agben/Silicon-Heaven/Acorn-Electron/Cumana-Disk-Interface/Cumana-Disk-Interface-pcb-top.png

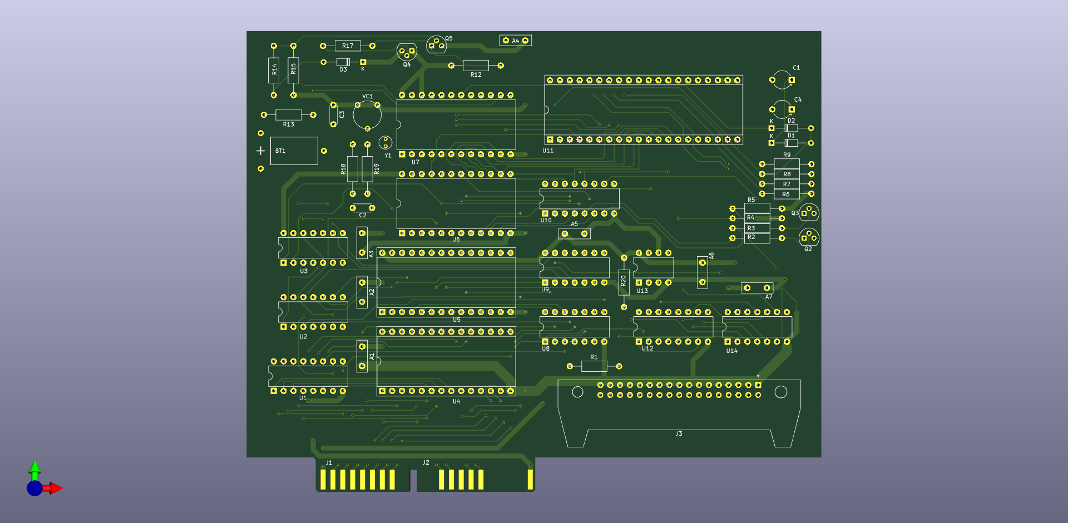
Acorn-Electron/Cumana-Disk-Interface/Cumana-Disk-Interface-pcb-top.png
