agben/Silicon-Heaven/Acorn-Electron/Cumana-Disk-Interface/Cumana-Disk-Interface-pcb-bottom.png

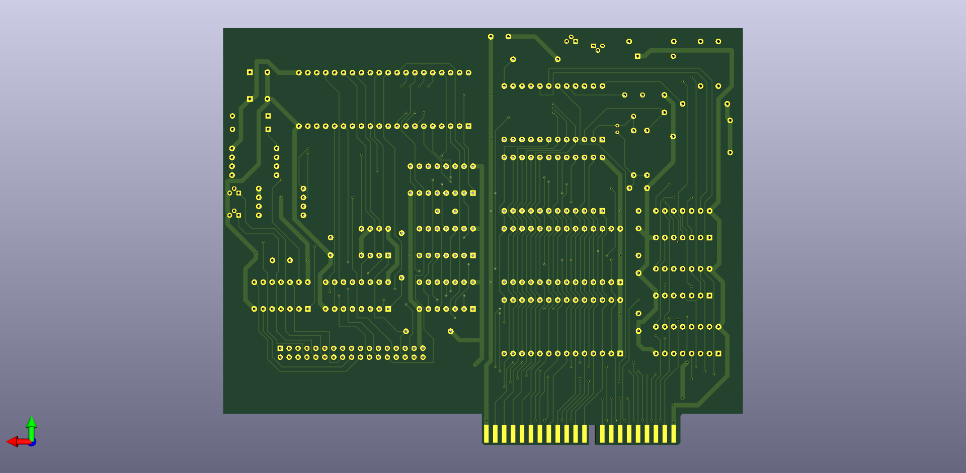
Acorn-Electron/Cumana-Disk-Interface/Cumana-Disk-Interface-pcb-bottom.png
