agben/Silicon-Heaven/README.md

**Silicon Heaven**
---
The afterlife for obsolete equipment and software.

For more on each entry see www.benningtons.net/index.php/category/silicon-heaven
