agben/Silicon-Heaven/Apple-II/Print-Buffer/schematic.pdf

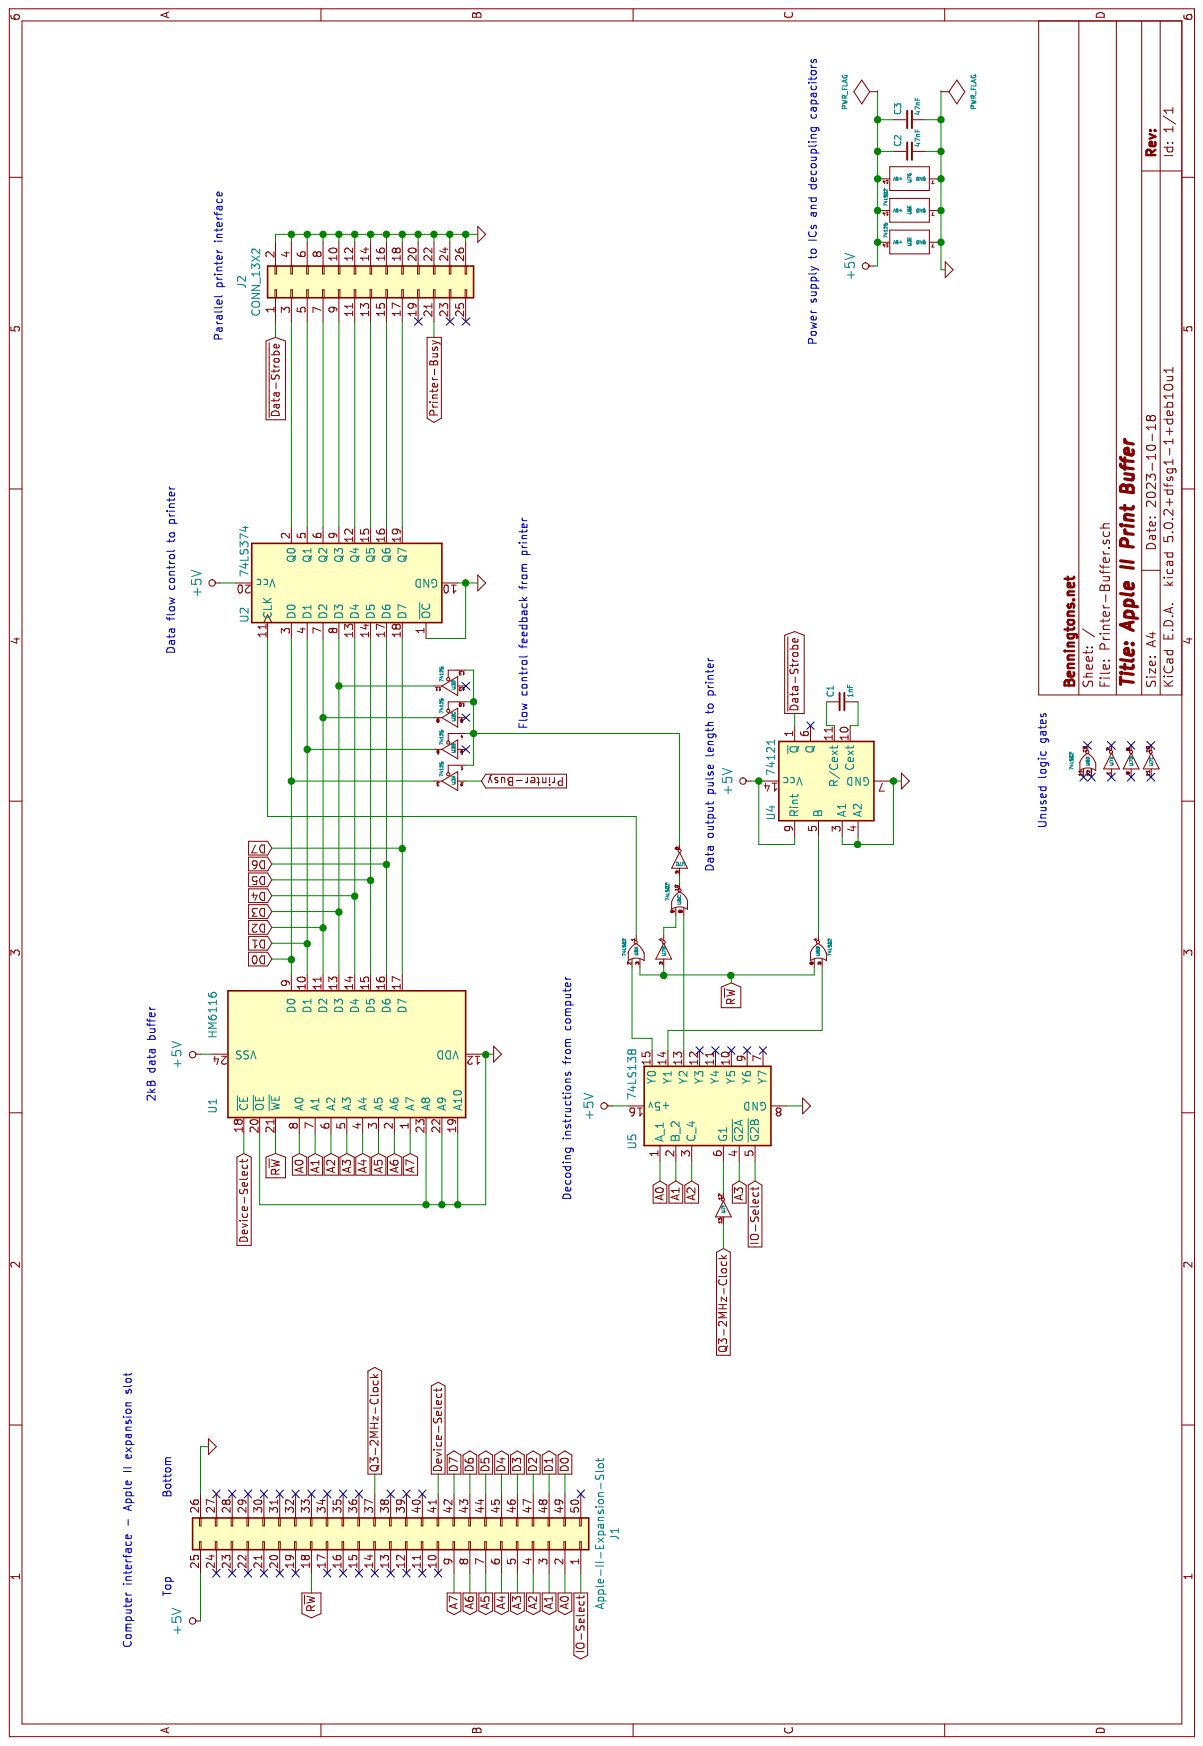
[picture p3: page 1]
