agben/Silicon-Heaven/Acorn-Electron/Cumana-Disk-Interface/schematic.pdf

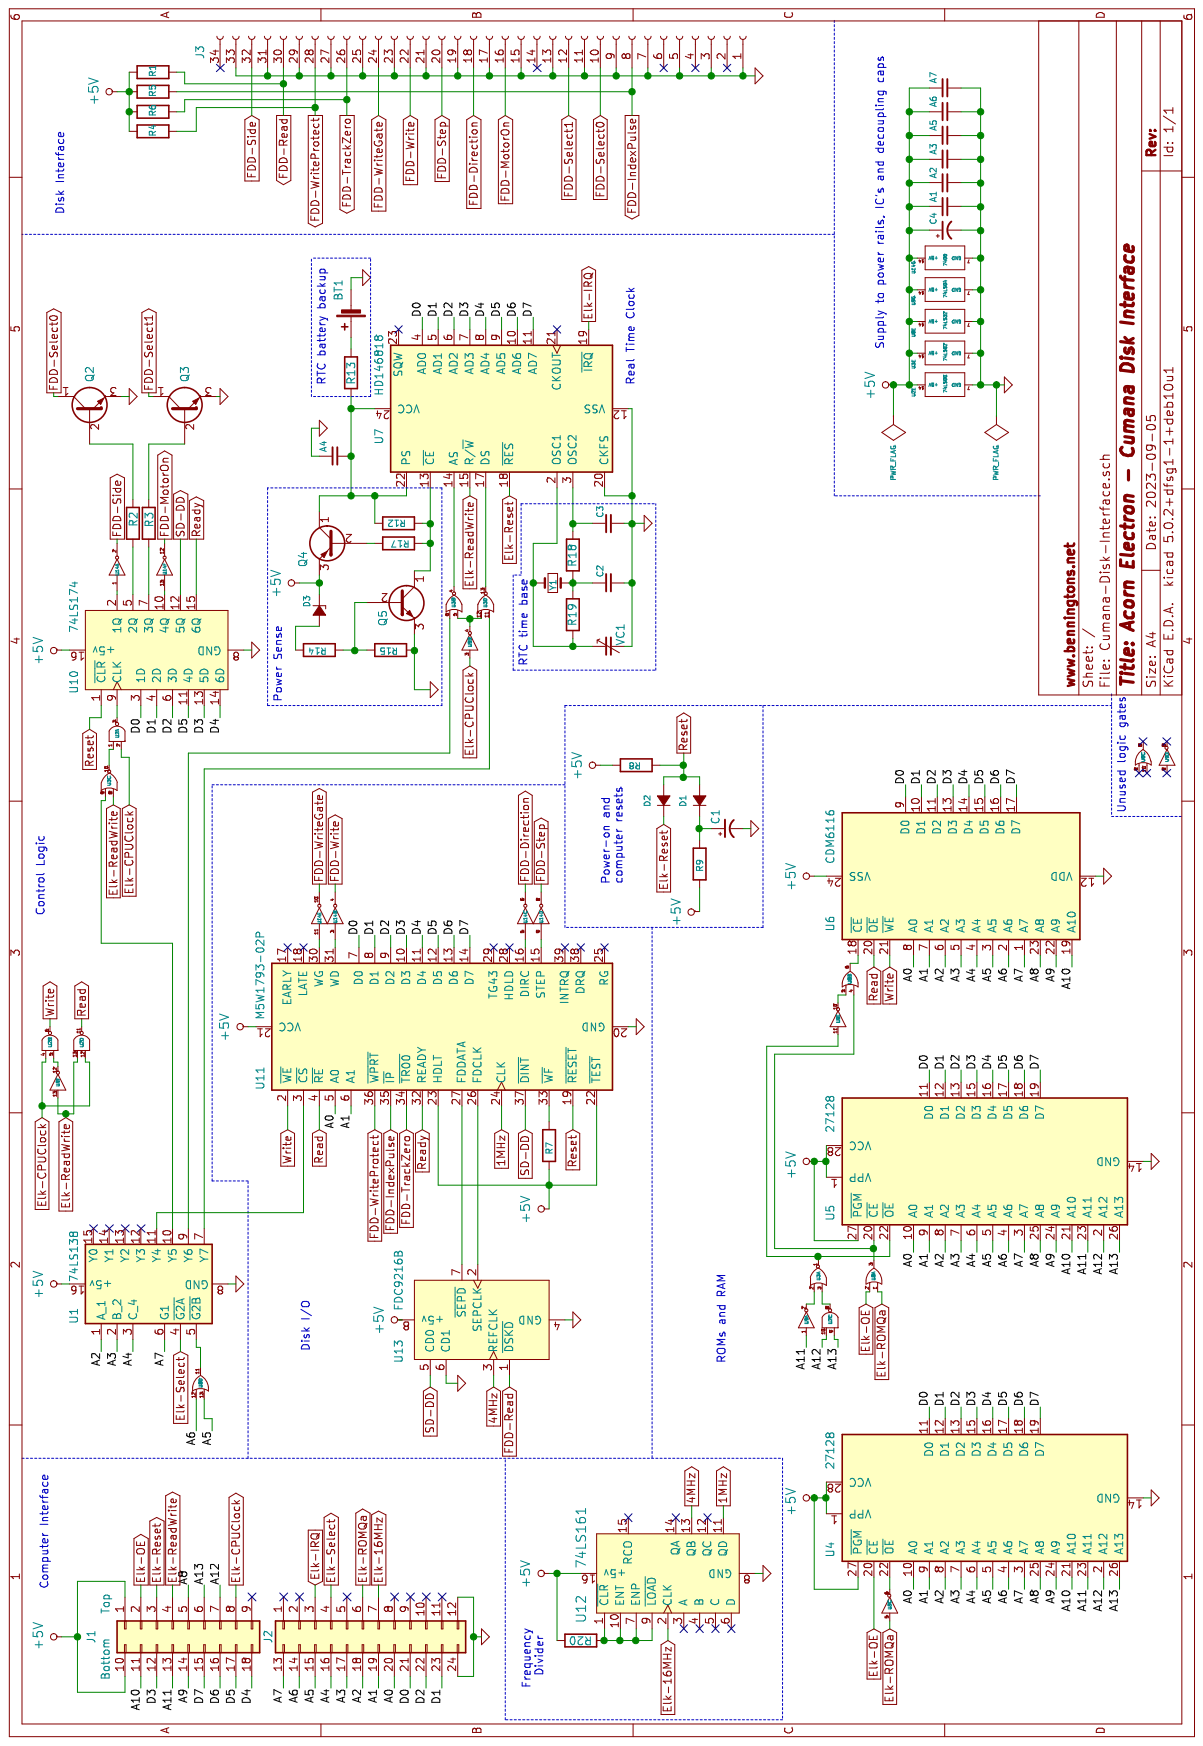
[picture p4: page 1]
