agben/Silicon-Heaven/Acorn-Electron/Cumana-Disk-Interface/Cumana-Disk-Interface.kicad_pcb

## KiCad design Acorn-Electron/Cumana-Disk-Interface/Cumana-Disk-Interface.kicad_pcb (2025-09-29)

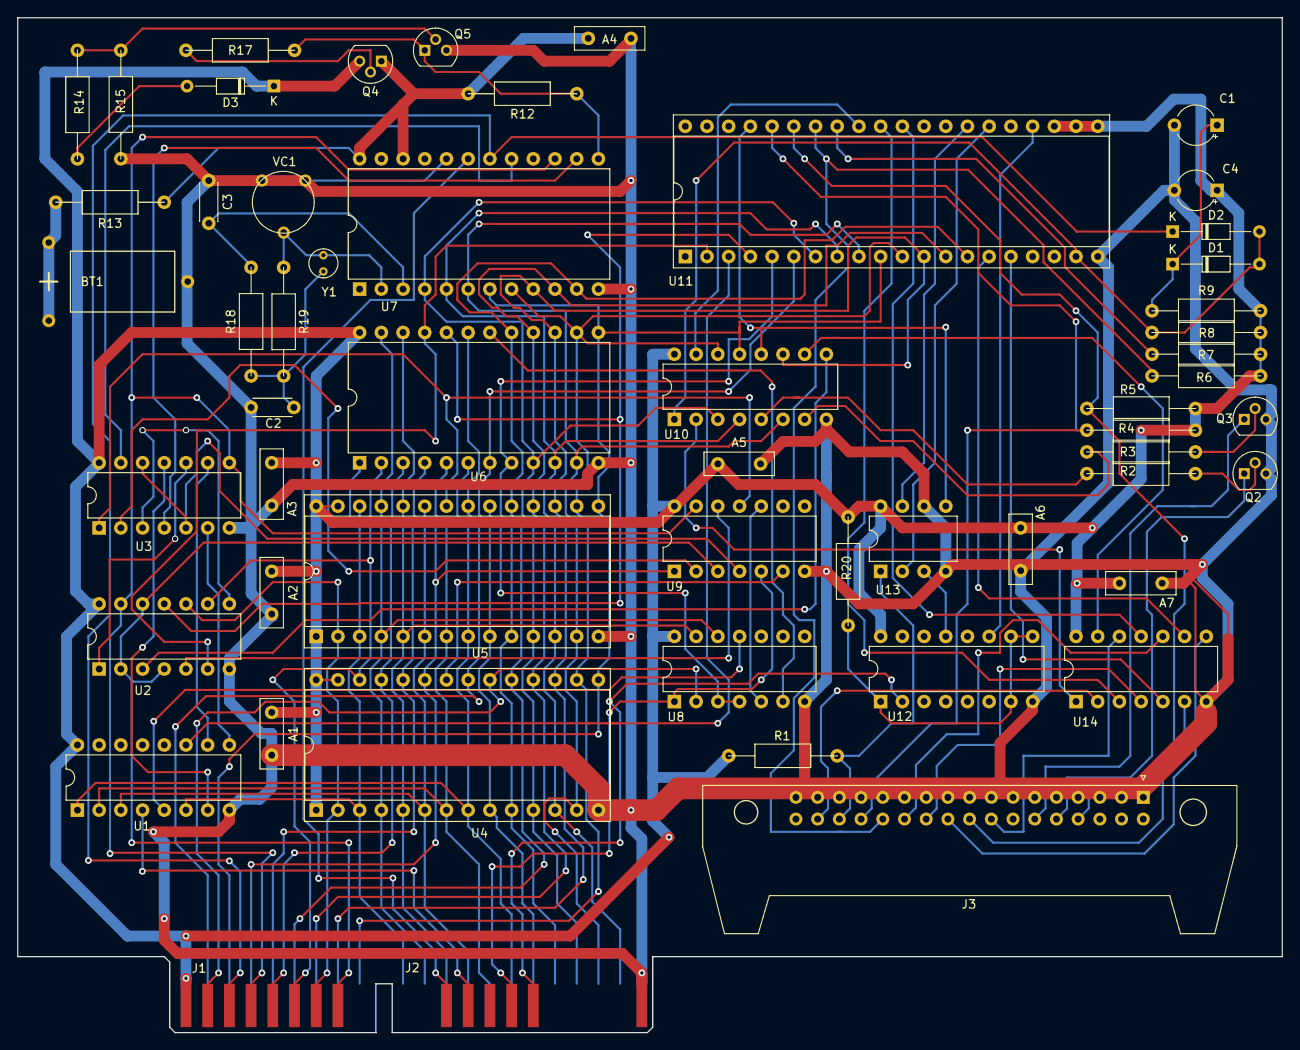
[picture p5: board Cumana-Disk-Interface.kicad_pcb from above]

Board: 2 copper layers, 148.0 x 118.7 mm, 55 parts (0 on the bottom side), 93 nets.

Parts:
A1, A2, A3, A4, A5, A6, A7: C; C_Disc_D8.0mm_W2.5mm_P5.00mm
BT1: Battery_Cell
C1, C4: CP1; CP_Radial_Tantal_D4.5mm_P5.00mm
C2, C3: C; C_Disc_D4.3mm_W1.9mm_P5.00mm
D1, D2: Diode; D_DO-34_SOD68_P10.16mm_Horizontal
D3: D_Zener; D_DO-34_SOD68_P10.16mm_Horizontal
J1: Bottom Top; Connector_2x9_P1.27mm_Polarized_Edge
J2: CONN_12X2; Connector_2x12_P1.27mm_Polarized_Edge
J3: Conn_01x34_Female; IDC-Header_2x17_P2.54mm_Horizontal_Lock
Q2, Q3, Q5: Q_NPN_CBE; TO-92
Q4: Q_PNP_CBE; TO-92
R1, R2, R3, R4, R5, R6, R7, R8, R9, R12, R13, R14, R15, R17, R18, R19, R20: R; R_Axial_DIN0212_L12.5mm_D2.5mm_Horizontal
U1: 74LS138; DIP-16_W7.62mm
U2: 74LS00; DIP-14_W7.62mm
U3: 74LS02; DIP-14_W7.62mm
U4, U5: 27128; DIP-28_W15.24mm_Socket
U6: CDM6116; DIP-24_W15.24mm
U7: HD146818; DIP-24_W15.24mm
U8: 74LS32; DIP-14_W7.62mm
U9: 74LS04; DIP-14_W7.62mm
U10: 74LS174; DIP-16_W7.62mm
U11: M5W1793-02P; DIP-40_W15.24mm_Socket
U12: 74LS161; DIP-16_W7.62mm
U13: FDC9216B; DIP-8_W7.62mm
U14: 7406; DIP-14_W7.62mm
VC1: C_Trimmer
Y1: Crystal_Small; Crystal_D3.0mm_Vertical

Connections:
1MHz: U11.24, U12.11
4MHz: U12.13, U13.3
+5V: A1.1, A2.1, A3.1, A5.1, A6.1, A7.1, C4.1, D3.1, J1.1, J1.10, Q4.3, R1.2, R4.2, R5.2, R6.2, R7.2, R8.2, R9.2, R20.1, U1.16, U2.14, U3.14, U4.1, U4.27, U4.28, U5.1, U5.27, U5.28, U6.24, U8.14, U9.14, U10.16, U11.21, U11.22, U11.23, U12.16, U13.8, U14.14
/A0: J2.20, U4.10, U5.10, U6.8, U11.5
/A1: J2.19, U4.9, U5.9, U6.7, U11.6
/A2: J2.18, U1.1, U4.8, U5.8, U6.6
/A3: J2.17, U1.2, U4.7, U5.7, U6.5
/A4: J2.16, U1.3, U4.6, U5.6, U6.4
/A5: J2.15, U4.5, U5.5, U6.3, U8.13
/A6: J2.14, U4.4, U5.4, U6.2, U8.12
/A7: J2.13, U1.6, U4.3, U5.3, U6.1
/A8: J1.5, U4.25, U5.25, U6.23
/A9: J1.14, U4.24, U5.24, U6.22
/A10: J1.11, U4.21, U5.21, U6.19
/A11: J1.13, U4.23, U5.23, U9.1
/A12: J1.7, U2.10, U4.2, U5.2
/A13: J1.6, U2.9, U4.26, U5.26
/D0: J2.21, U4.11, U5.11, U6.9, U7.4, U10.3, U11.7
/D1: J2.23, U4.12, U5.12, U6.10, U7.5, U10.4, U11.8
/D2: J2.22, U4.13, U5.13, U6.11, U7.6, U10.6, U11.9
/D3: J1.12, U4.15, U5.15, U6.13, U7.7, U10.13, U11.10
/D4: J1.18, U4.16, U5.16, U6.14, U7.8, U10.14, U11.11
/D5: J1.17, U4.17, U5.17, U6.15, U7.9, U10.11, U11.12
/D6: J1.16, U4.18, U5.18, U6.16, U7.10, U11.13
/D7: J1.15, U4.19, U5.19, U6.17, U7.11, U11.14
Elk-16MHz: J2.7, U12.2
Elk-CPUClock: J1.8, U2.2, U2.4, U2.12, U9.3
Elk-IRQ: J2.3, U7.19
Elk-OE: J1.2, U4.20, U8.2
Elk-ROMQa: J2.6, U8.1, U9.5
Elk-ReadWrite: J1.4, U2.13, U3.8, U7.15, U9.13
Elk-Reset: D2.1, J1.3, U7.18
Elk-Select: J2.4, U1.4
FDD-Direction: J3.18, U14.6
FDD-IndexPulse: J3.8, R5.1, U11.35
FDD-MotorOn: J3.16, U14.12
FDD-Read: J3.30, R1.1, U13.1
FDD-Select0: J3.10, Q2.1
FDD-Select1: J3.12, Q3.1
FDD-Side: J3.32, U14.2
FDD-Step: J3.20, U14.8
FDD-TrackZero: J3.26, R6.1, U11.34
FDD-Write: J3.22, U14.4
FDD-WriteGate: J3.24, U14.10
FDD-WriteProtect: J3.28, R4.1, U11.36
GND: A1.2, A2.2, A3.2, A4.1, A5.2, A6.2, A7.2, BT1.2, C1.2, C2.1, C3.1, C4.2, J2.12, J2.24, J3.1, J3.3, J3.5, J3.7, J3.9, J3.11, J3.13, J3.15, J3.17, J3.19, J3.21, J3.23, J3.25, J3.27, J3.29, J3.31, J3.33, Q2.3, Q3.3, Q5.3, R15.1, U1.8, U2.7, U3.7, U4.14, U5.14, U6.12, U7.12, U7.20, U8.7, U9.7, U10.8, U11.20, U12.8, U13.4, U13.6, U14.7, VC1.2
unnamed: A4.2, Q4.1, R12.2, R13.2, U7.22, U7.24
unnamed: BT1.1, R13.1
unnamed: C1.1, D1.1, R9.1
unnamed: C2.2, R18.1, R19.2, Y1.2
unnamed: C3.2, R18.2, U7.3
unnamed: D3.2, R14.2
unnamed: Q2.2, R2.1
unnamed: Q3.2, R3.1
unnamed: Q4.2, R17.1
unnamed: Q5.1, R12.1, R17.2, U7.13
unnamed: Q5.2, R14.1, R15.2
unnamed: R2.2, U10.5
unnamed: R3.2, U10.7
unnamed: R7.1, U11.33
unnamed: R19.1, U7.2, VC1.1, Y1.1
unnamed: R20.2, U12.1, U12.7, U12.9, U12.10
unnamed: U1.5, U8.11
unnamed: U1.7, U3.11
unnamed: U1.9, U3.6
unnamed: U1.10, U3.9
unnamed: U1.11, U11.3
unnamed: U2.1, U3.10
unnamed: U2.5, U9.12
unnamed: U2.8, U3.3
unnamed: U3.1, U5.22, U9.11
unnamed: U3.2, U9.2
unnamed: U3.4, U7.14
unnamed: U3.5, U3.12, U9.4
unnamed: U3.13, U7.17
unnamed: U4.22, U9.6
unnamed: U5.20, U8.3, U8.4
unnamed: U6.18, U8.6
unnamed: U8.5, U9.10
unnamed: U10.2, U14.1
unnamed: U2.3, U10.9
unnamed: U10.10, U14.13
unnamed: U11.15, U14.9
unnamed: U11.16, U14.5
unnamed: U11.26, U13.2
unnamed: U11.27, U13.7
unnamed: U11.30, U14.11
unnamed: U11.31, U14.3
Read: U2.11, U6.20, U11.4
Ready: U10.15, U11.32
Reset: D1.2, D2.2, R8.1, U10.1, U11.19
SD-DD: U10.12, U11.37, U13.5
Write: U2.6, U6.21, U11.2
