agben/Silicon-Heaven/Apple-II/Print-Buffer/Printer-Buffer.kicad_pcb

## KiCad design Apple-II/Print-Buffer/Printer-Buffer.kicad_pcb (2025-09-28)

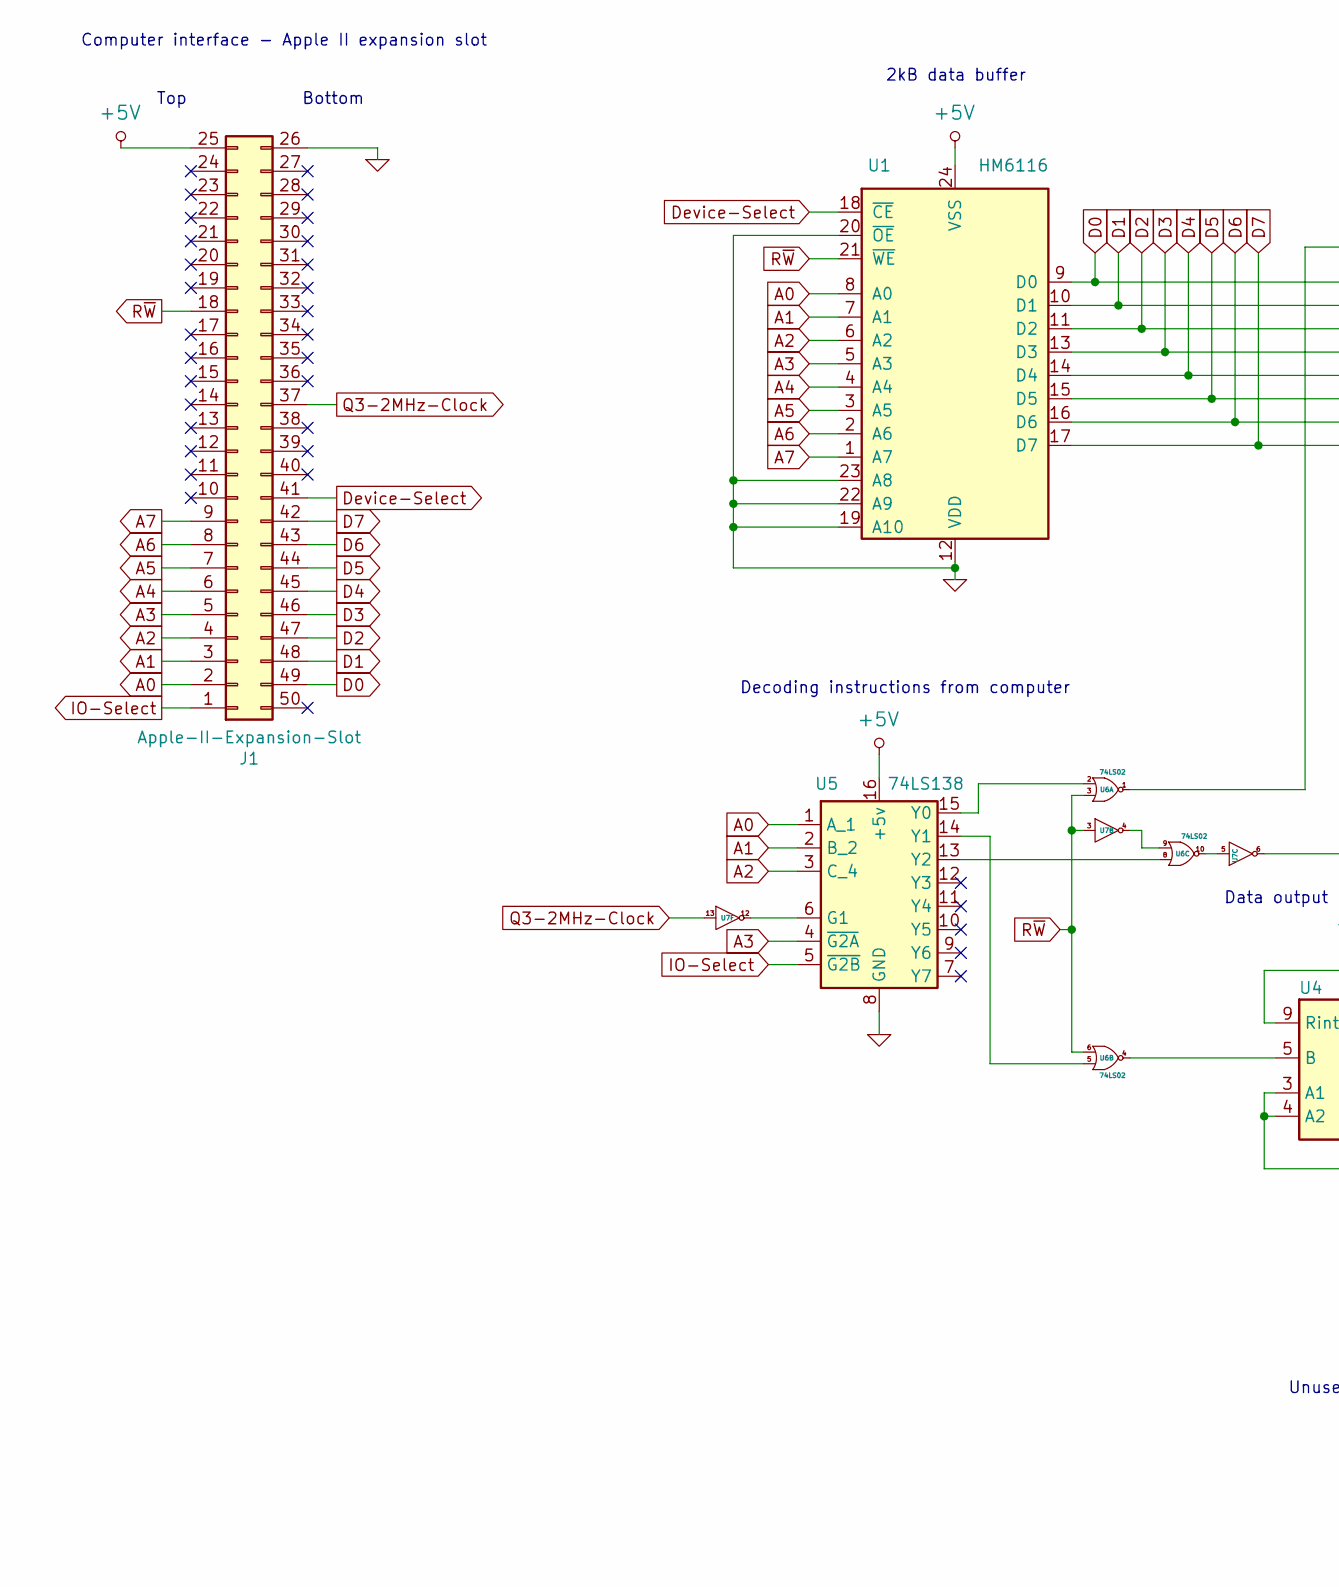
[picture p6: schematic Printer-Buffer.kicad_sch, Apple II Print Buffer, part in row 1, column 1]

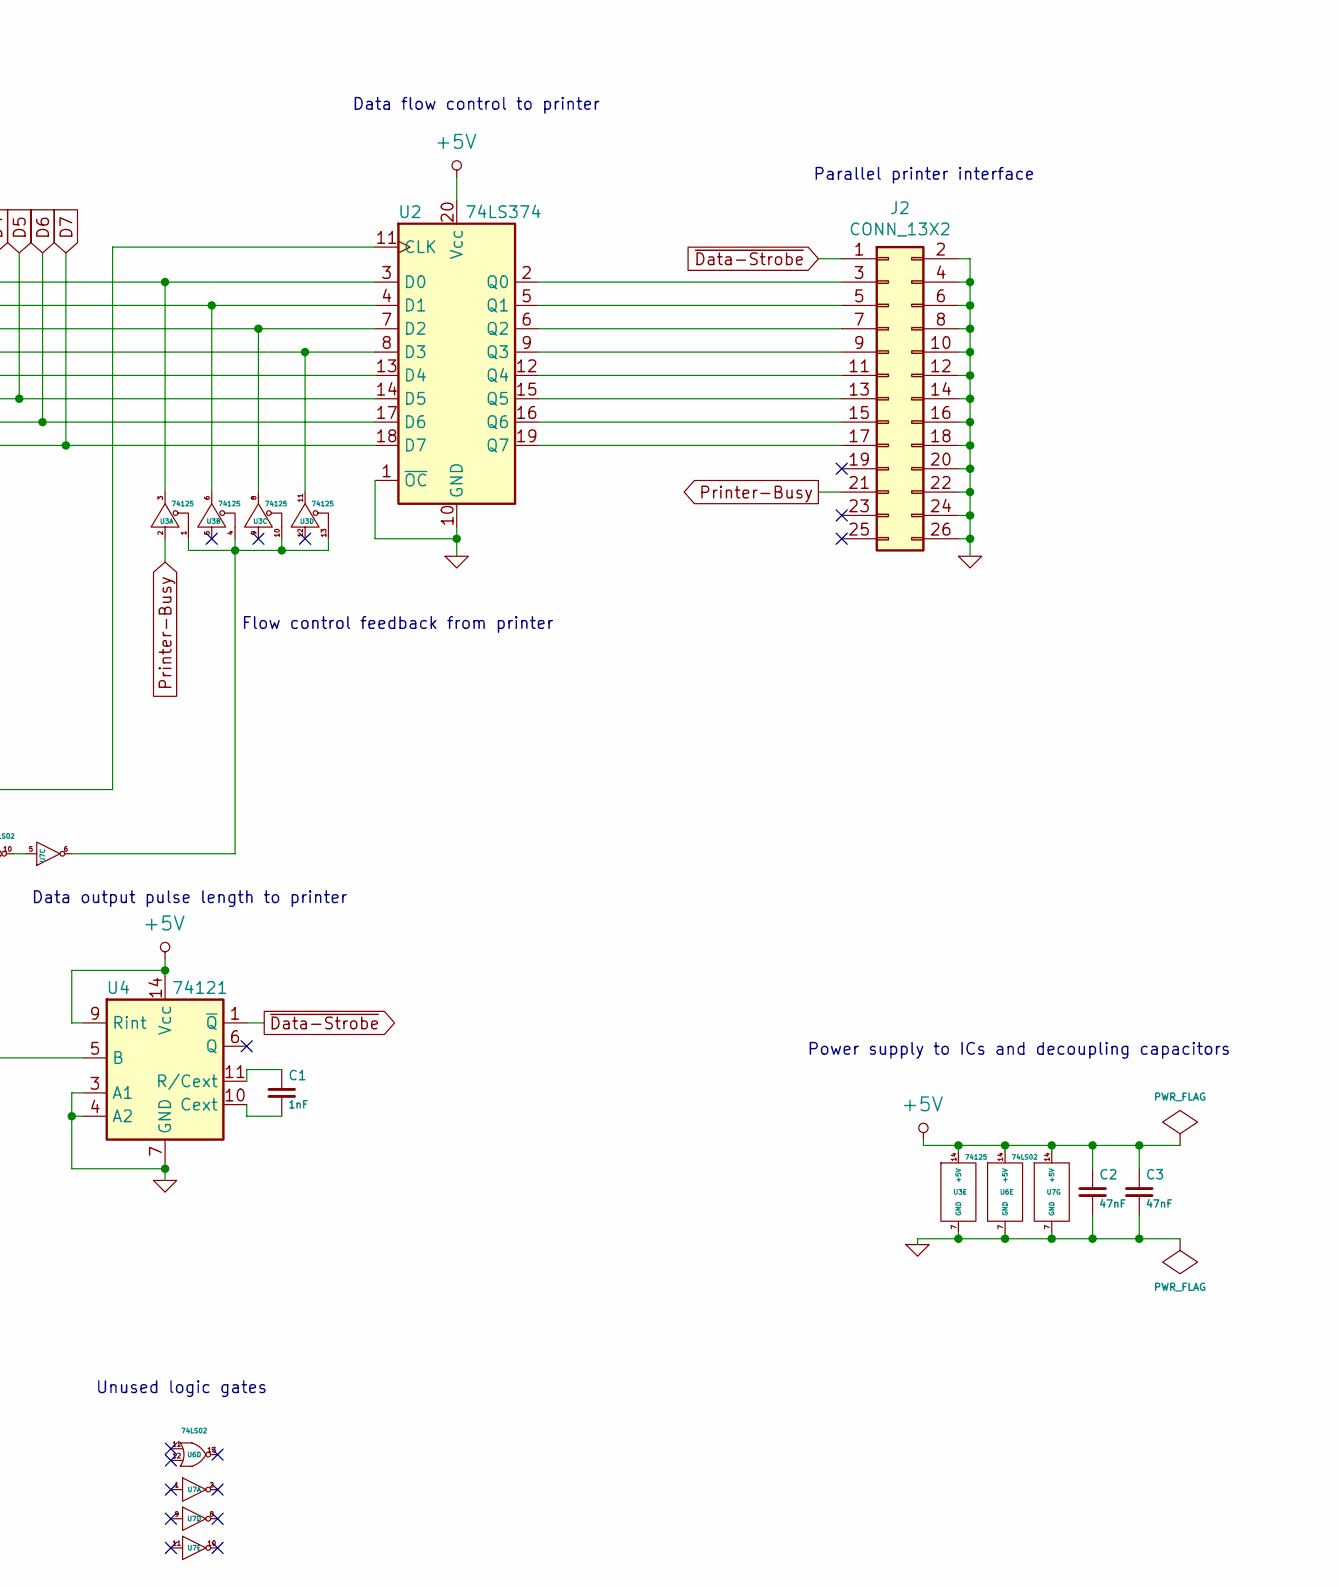
[picture p7: schematic Printer-Buffer.kicad_sch, Apple II Print Buffer, part in row 1, column 2]

Parts:
C1: 1nF; C_Rect_L7.0mm_W2.0mm_P5.00mm
C2, C3: 47nF; C_Rect_L7.0mm_W2.0mm_P5.00mm
J1: Apple-II-Expansion-Slot; Connector_2x25_P1.27mm_Polarized_Edge
J2: CONN_13X2; IDC-Header_2x13_P2.54mm_Vertical_Lock
U1: HM6116; DIP-24_W15.24mm
U2: 74LS374; DIP-20_W7.62mm
U3: 74125; DIP-14_W7.62mm
U4: 74121; DIP-14_W7.62mm
U5: 74LS138; DIP-16_W7.62mm
U6: 74LS02; DIP-14_W7.62mm
U7: 7404; DIP-14_W7.62mm

Connections:
+5V: C2.1, C3.1, J1.25, U1.24 (VSS), U2.20 (Vcc), U3.14 (+5V), U4.9 (Rint), U4.14 (Vcc), U5.16 (+5v), U6.14 (+5V), U7.14 (+5V)
A0: J1.2, U1.8 (A0), U5.1 (A_1)
A1: J1.3, U1.7 (A1), U5.2 (B_2)
A2: J1.4, U1.6 (A2), U5.3 (C_4)
A3: J1.5, U1.5 (A3), U5.4 (~G2A)
A4: J1.6, U1.4 (A4)
A5: J1.7, U1.3 (A5)
A6: J1.8, U1.2 (A6)
A7: J1.9, U1.1 (A7)
D0: J1.49, U1.9 (D0), U2.3 (D0), U3.3
D1: J1.48, U1.10 (D1), U2.4 (D1), U3.6
D2: J1.47, U1.11 (D2), U2.7 (D2), U3.8
D3: J1.46, U1.13 (D3), U2.8 (D3), U3.11
D4: J1.45, U1.14 (D4), U2.13 (D4)
D5: J1.44, U1.15 (D5), U2.14 (D5)
D6: J1.43, U1.16 (D6), U2.17 (D6)
D7: J1.42, U1.17 (D7), U2.18 (D7)
Device-Select: J1.41, U1.18 (~CE)
GND: C2.2, C3.2, J1.26, J2.2, J2.4, J2.6, J2.8, J2.10, J2.12, J2.14, J2.16, J2.18, J2.20, J2.22, J2.24, J2.26, U1.12 (VDD), U1.19 (A10), U1.20 (~OE), U1.22 (A9), U1.23 (A8), U2.1 (~OC), U2.10 (GND), U3.7 (GND), U4.3 (A1), U4.4 (A2), U4.7 (GND), U5.8 (GND), U6.7 (GND), U7.7 (GND)
IO-Select: J1.1, U5.5 (~G2B)
unnamed: C1.1, U4.11 (R/Cext)
unnamed: C1.2, U4.10 (Cext)
unnamed: J2.3, U2.2 (Q0)
unnamed: J2.5, U2.5 (Q1)
unnamed: J2.7, U2.6 (Q2)
unnamed: J2.9, U2.9 (Q3)
unnamed: J2.11, U2.12 (Q4)
unnamed: J2.13, U2.15 (Q5)
unnamed: J2.15, U2.16 (Q6)
unnamed: J2.17, U2.19 (Q7)
unnamed: U2.11 (CLK), U6.1
unnamed: U3.1, U3.4, U3.10, U3.13, U7.6
unnamed: U4.5 (B), U6.4
unnamed: U5.6 (G1), U7.12
unnamed: U5.13 (Y2), U6.8
unnamed: U5.14 (Y1), U6.5
unnamed: U5.15 (Y0), U6.2
unnamed: U6.9, U7.4
unnamed: U6.10, U7.5
Printer-Busy: J2.21, U3.2
Q3-2MHz-Clock: J1.37, U7.13
R~W: J1.18, U1.21 (~WE), U6.3, U6.6, U7.3
~Data-Strobe: J2.1, U4.1 (~Q)

Notes on the sheet:
Flow control feedback from printer
Decoding instructions from computer
2kB data buffer
Top Bottom
Power supply to ICs and decoupling capacitors
Computer interface - Apple II expansion slot
Unused logic gates
Data output pulse length to printer
Parallel printer interface
Data flow control to printer

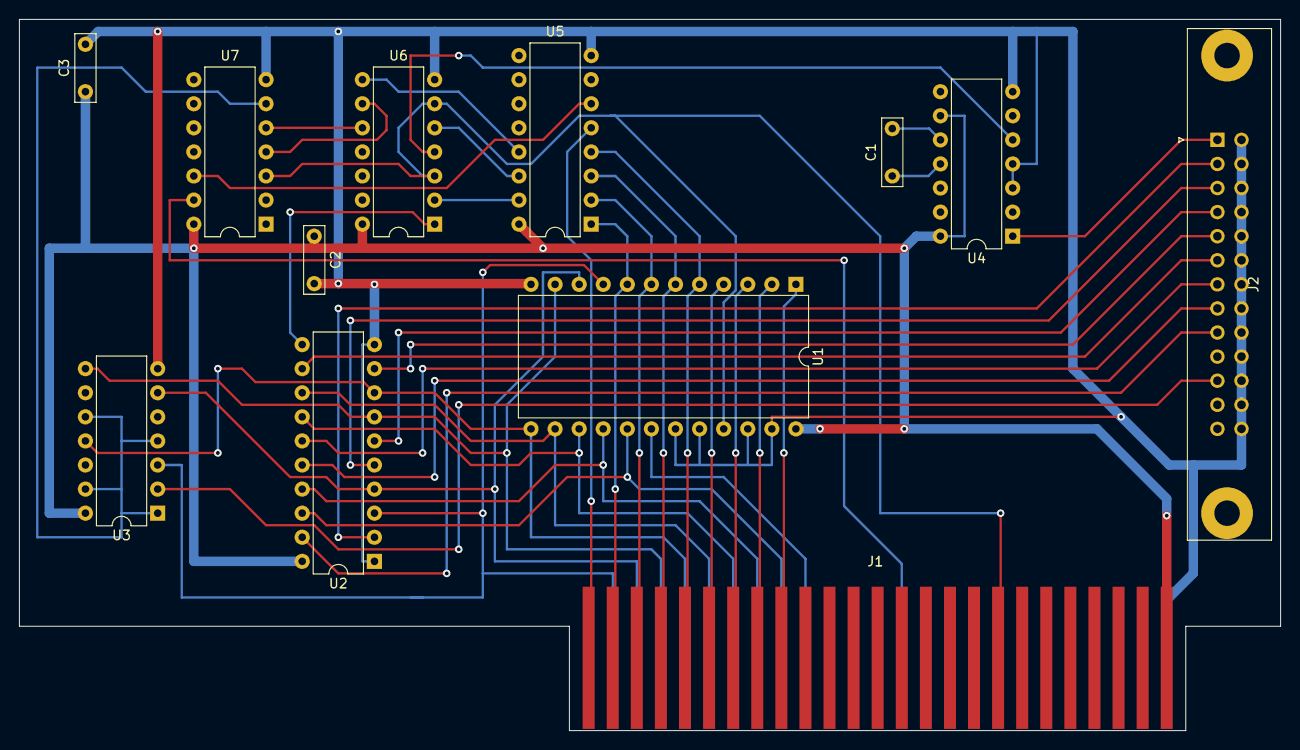
[picture p8: board Printer-Buffer.kicad_pcb from above]

Board: 2 copper layers, 133.0 x 75.0 mm, 12 parts (0 on the bottom side), 43 nets.
