agben/Silicon-Heaven/Apple-II/Print-Buffer/Printer-Buffer-PCB-bottom.png

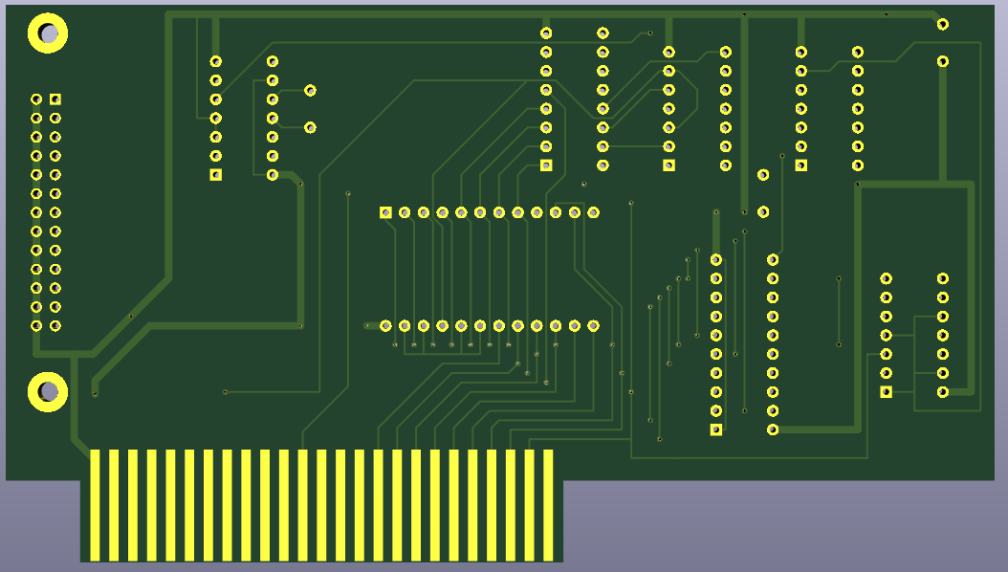
Apple-II/Print-Buffer/Printer-Buffer-PCB-bottom.png
