agben/Silicon-Heaven/Apple-II/Print-Buffer/Printer-Buffer-PCB-top.png

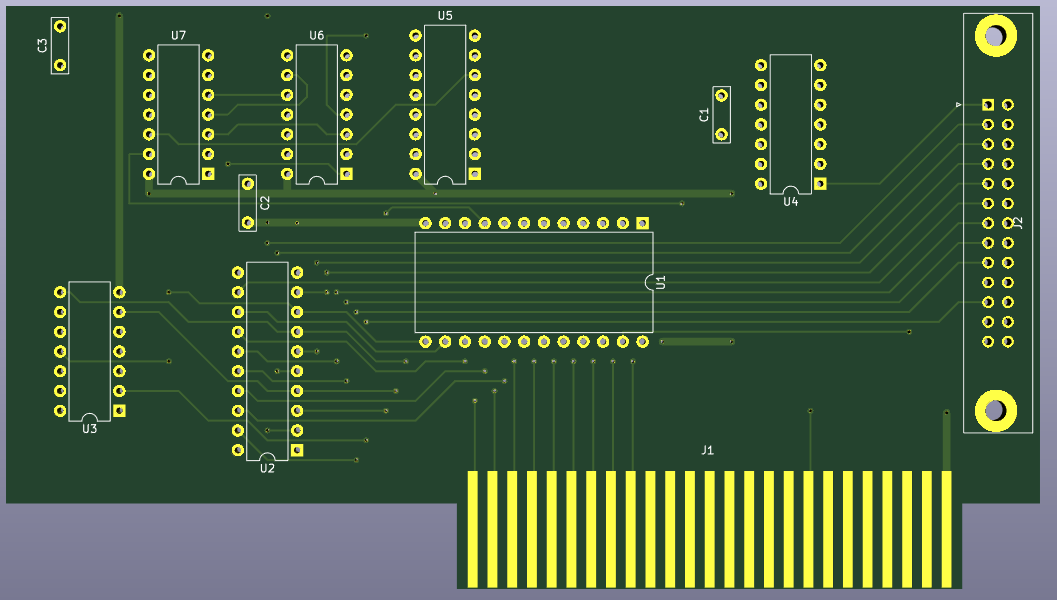
Apple-II/Print-Buffer/Printer-Buffer-PCB-top.png
