agben/Silicon-Heaven/(commit log)

2023-08-22 Cumana disk interface schematic
    [Cumana-Disk-Interface.kicad_pcb, Cumana-Disk-Interface.sch]
2023-08-23 Cumana disk interface schematic update and pdf
    [Cumana-Disk-Interface.sch]
2023-08-23 Cumana disk interface schematic update
    [Cumana-Disk-Interface.sch]
2023-08-25 Cumana disk interface - charge battery
    [Cumana-Disk-Interface.sch]
2023-08-31 corrections and footptint selections
    [Cumana-Disk-Interface.sch]
2023-09-05 added footprints and pcb
    [Cumana-Disk-Interface.kicad_pcb, Cumana-Disk-Interface.sch]
2023-09-13 top and bottom images of the pcb
2023-09-13 silk screen corrections
    [Cumana-Disk-Interface.kicad_pcb]
2023-09-19 bill of materials added
    [Cumana-Disk-Interface.sch]
2023-10-18 Apple II printer buffer initial schematic
    [Print-Buffer.kicad_pcb, Printer-Buffer.sch]
2023-10-22 netlist and footprints
    [Printer-Buffer.sch]
2023-10-22 show values for caps and resistors
    [Cumana-Disk-Interface.sch, Printer-Buffer.sch]
2023-10-27 PCB layout
    [Print-Buffer.kicad_pcb, Printer-Buffer.kicad_pcb, Printer-Buffer.sch]
2023-10-30 PCB tweaks and some images
    [Printer-Buffer.kicad_pcb]
2025-09-28 upgraded to KiCad 6.0
    [Printer-Buffer.kicad_pcb, Printer-Buffer.kicad_sch, Printer-Buffer.sch]
